jh442/zmk-config/files/CAD/Bottom Slant Right.3mf

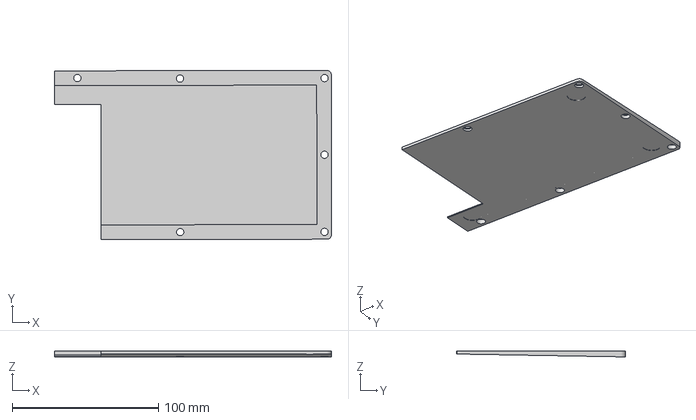
[picture p10: CAD file, 2023-03-05]
files/CAD/Bottom Slant Right.3mf
189.2 x 115.4 x 3.99 mm
