jh442/zmk-config/files/CAD/Top Left Border.3mf

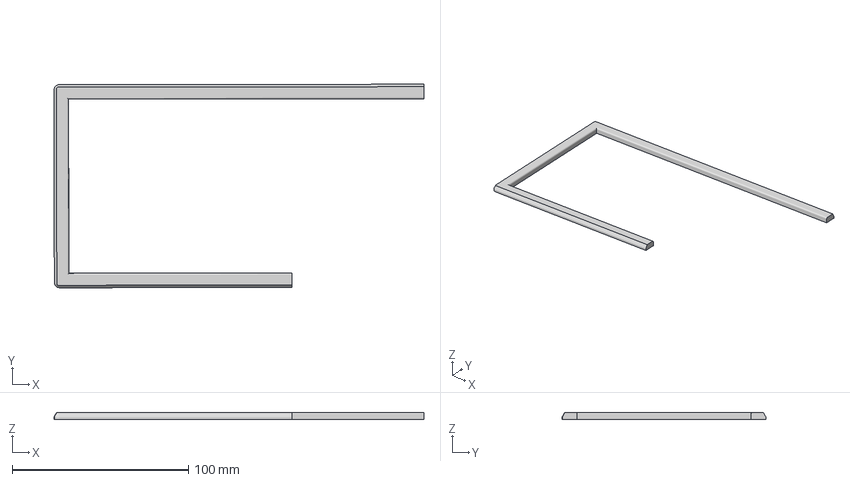
[picture p11: CAD file, 2023-03-05]
files/CAD/Top Left Border.3mf
209.9 x 115.5 x 4.00 mm
