jh442/zmk-config/files/CAD/Right Plate.3mf

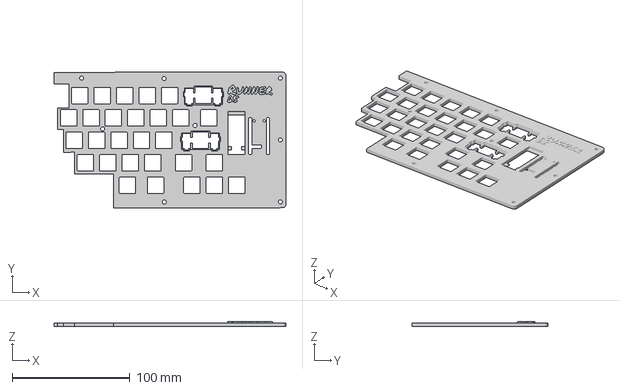
[picture p12: CAD file, 2023-03-05]
files/CAD/Right Plate.3mf
197.0 x 115.4 x 4.00 mm
