jh442/zmk-config/files/CAD/Body Right (w ports).3mf

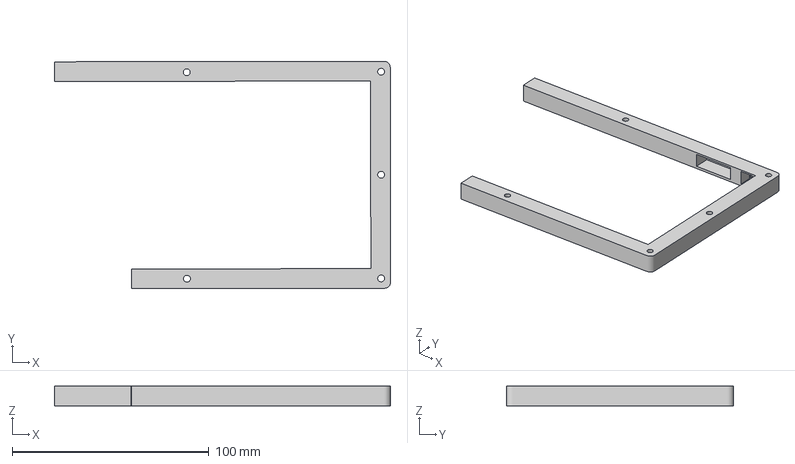
[picture p13: CAD file, 2023-03-05]
files/CAD/Body Right (w ports).3mf
170.6 x 115.4 x 10.0 mm
