jh442/zmk-config/files/CAD/Body Left.3mf

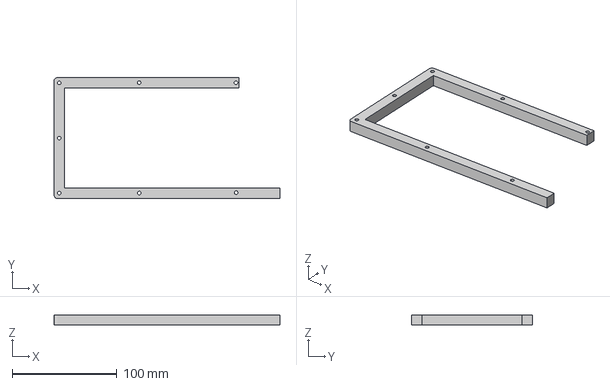
[picture p14: CAD file, 2023-03-05]
files/CAD/Body Left.3mf
215.4 x 115.5 x 10.0 mm
