jh442/zmk-config/files/CAD/Top Right Border.3mf

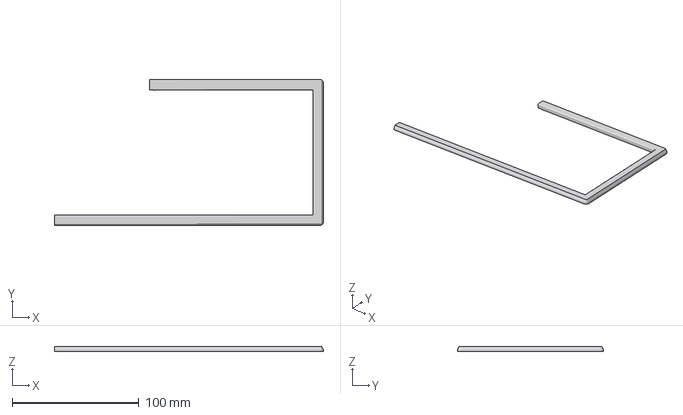
[picture p15: CAD file, 2023-03-05]
files/CAD/Top Right Border.3mf
212.2 x 115.5 x 4.00 mm
