jh442/zmk-config/files/CAD/Bottom Slant Left.3mf

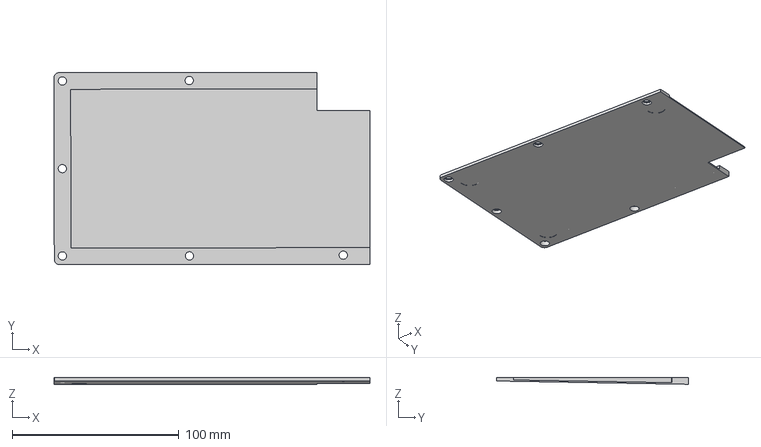
[picture p16: CAD file, 2023-03-05]
files/CAD/Bottom Slant Left.3mf
189.6 x 115.4 x 3.99 mm
