jh442/zmk-config/files/CAD/Left Plate.3mf

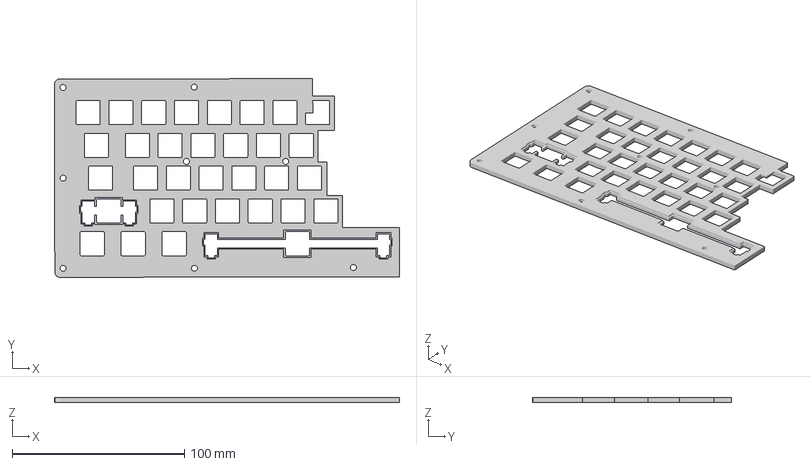
[picture p17: CAD file, 2023-03-05]
files/CAD/Left Plate.3mf
200.4 x 115.4 x 3.00 mm
