jh442/zmk-config/(commit log)

2023-01-22 Testing some code against actual wires
    I have a test row and column going to see if the matrix works on a breadboard.
2023-02-19 Updating issues with semi colons vs commas
    devicetree error: /__w/zmk-config/zmk-config/config/boards/shields/runner65/runner65.overlay:19 (column 21): parse error: expected node name, property name, or '}'
2023-02-19 Potential pin reference name issue
2023-02-26 Re-ordering pins for easier space in soldering
2023-02-28 Adjusting volume and page up/downs
    Removing the F11 and F12 short cut for volume
    Adding page up/down to the arrow keys
2023-02-28 Showing battery percentage
2023-03-05 Adding 3MF 3D Printing Files
    [Body Left.3mf, Body Right (w ports).3mf, Bottom Slant Left.3mf, Bottom Slant Right.3mf, Left Plate.3mf, Right Plate.3mf, Top Left Border.3mf, Top Right Border.3mf]
2023-11-25 Increasing the sleep timer
    Got used to the longer timeout on the ergo and like it a lot more.
2023-11-25 Trying to make sure I have the right pin mapping
